MagentaFlame/HackLifeLastWeek/README.md

Helloooo this is last week of design for hack life, and I'm doing a split keyboard!
Ever since I learned about being able to do one from Hack club, I've been looking for opportunities to. Now that I got one, hopefully I have enough free time to do it. I feel bad about not doing my college apps and my tons of hw...

Schematic!

The labels are kind of scuffed. I pretty much made a matrix of 25 keys, using as much as possible, and customized where the pins pointed to so it was easier to route on the pcb. 

PCB!

This took so so long. So currently, most of the letter keys are assembled in a staggered format, similar to a regular keyboard. This is to retain muscle memory for typing and gaming. The ctrl button the left side and space button on the right are still within the 5x5 matrix for the pins, but are one row down for muscle memory.

Code!

I had to create a custom keyboard module using zmk. I learned and implemented making new shields for each side, setting ids, doing soft-off power management, and doing keymaps. In the keymaps, mod-morphs, macros, hold-taps, and regular kps were used to give more complex, unique functionalities. This way, it isn't one/two outputs for each press, but potentially 3/4 depending on which layer (gaming or default) is toggled and the combination of keys pressed. 
I also made sure to write my configs down for future reference and to make sure I don't forget over the few days I do this project.


CAD!


Okay so I wanted the two sides to be vastly different - one hard and modern, while the other more flowy. But, the flowy side isn't to my liking as much as the geometric side b/c I didn't make it flowy enough lol. Anyways, hopefully the color combos will be good. I add only engravings this time, b/c extra details like changing wall geometry and embossing will take time I don't have unfortunately.
The pictures show the colors for the cases. The keycaps for the purple side will be gray and more jagged than the red keycaps on the orange side.
https://cad.onshape.com/documents/0349a2efe14c8a7447e63041/w/2e8c132947c776d3aa7bf3c9/e/34fe7648d6cb8c38b9c40c14 

BOM!

| Item | Qty |	Supplier | Cost/item |	Total Cost |	link |
| ---- | --- |  --- | --- | --- | ----- |
|Lipo batteries 2pc	|1|	Aliexpress|	$6.39|	$6.39|	https://www.aliexpress.us/item/3256813194775738.html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 |
|Hot swap sockets|	1|Aliexpress|	$5.43|	$5.43|	https://www.aliexpress.us/item/2251832764937566.html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|
|2M Resistor (100pc)|	1|	Aliexpress|	$1.86	|$1.86	|https://www.aliexpress.us/item/3256806797741926.html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|
|806k Resistor (100pc)	|1|	Aliexpress|	$2.28|	$2.28|	https://www.aliexpress.us/item/3256804997915352.html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|
|1N5819 diode (100pc)|	1|	Aliexpress|	$2.52|	$2.52|	https://aliexpress.us/item/3256811563559109.html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|
|Outemu Silent Lemon v3 Switch (50pc)|	1|	Aliexpress|	$9.49|	$9.49|	https://www.aliexpress.us/item/3256806837508228.html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|
|XIAO nRF52840|	2|	Seeed Studio|	$9.99|	$19.98	|https://www.seeedstudio.com/Seeed-XIAO-BLE-nRF52840-p-5201.html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|
|Custom pcb|	1|	JLCPCB|	$16.95|	$16.95|	https://cart.jlcpcb.com/shopcart/cart/|
|M2 screws 6mm (200pc)|	1|	Aliexpress|	$2.43|	$2.43|	https://aliexpress.us/item/3256808326585307.html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|
|Estimated total shipping|	1|			$11.10|

Only after making the hardware did I realized just how much it costs, even with Aliexpress and the 11.11 deals (hopefully I can get this approved by then). The microcontrollers and custom pcb cost the most, but that is to be expected. Just once added together, it accumulated to a lot. I think I can get enough hours for the tier 3 funding though.
