MagentaFlame/HackLifeLastWeek/BOM.csv

Item | Qty | Supplier | Cost/item | Total Cost | link
Lipo batteries 2pc | 1 | Aliexpress | $6.39 | $6.39 | https://www.aliexpress.us/item/3256813194775738.html?mp=1
Hot swap sockets | 1 | Aliexpress | $5.43 | $5.43 | https://www.aliexpress.us/item/2251832764937566.html?mp=1
2M Resistor (100pc) | 1 | Aliexpress | $1.86 | $1.86 | https://www.aliexpress.us/item/3256806797741926.html?mp=1&_randl_shipto=US
806k Resistor (100pc) | 1 | Aliexpress | $2.28 | $2.28 | https://www.aliexpress.us/item/3256804997915352.html?mp=1
1N5819 diode (100pc) | 1 | Aliexpress | $2.52 | $2.52 | https://aliexpress.us/item/3256811563559109.html?mp=1&_randl_shipto=US
Outemu Silent Lemon v3 Switch (50pc) | 1 | Aliexpress | $9.49 | $9.49 | https://www.aliexpress.us/item/3256806837508228.html?mp=1
XIAO nRF52840 | 2 | Seeed Studio | $9.99 | $19.98 | https://www.seeedstudio.com/Seeed-XIAO-BLE-nRF52840-p-5201.html
Custom pcb | 1 | JLCPCB | $16.95 | $16.95 | https://cart.jlcpcb.com/shopcart/cart/
M2 screws 6mm (200pc) | 1 | Aliexpress | $2.43 | $2.43 | https://aliexpress.us/item/3256808326585307.html?mp=1&_randl_shipto=US
Custom case + keycaps | 1 | Printing Legion | $15.50 | $15.50 | https://hackclub.slack.com/archives/C083P4FJM46/p1794163829539309
Estimated total shipping | 1 |  |  | $20.10
