MagentaFlame/HackLifeLastWeek/CAD/leftcase - left top plate.step

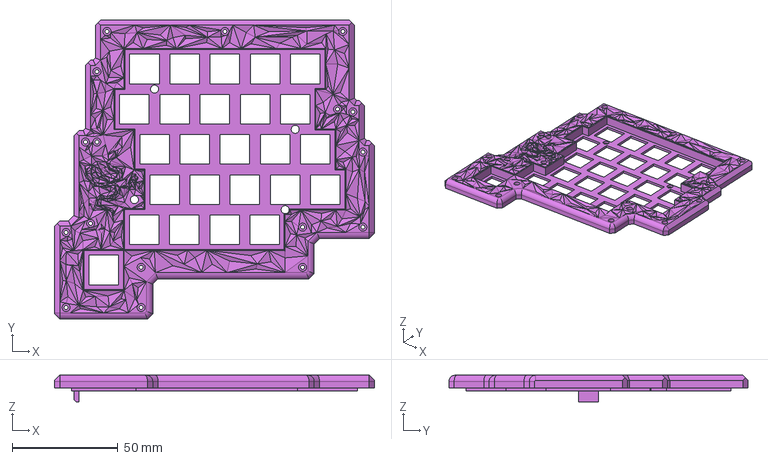
[picture p1: CAD file, 2026-11-08]
CAD/leftcase - left top plate.step
151.7 x 141.8 x 12.6 mm
