MagentaFlame/HackLifeLastWeek/CAD/rightcase - right top.step

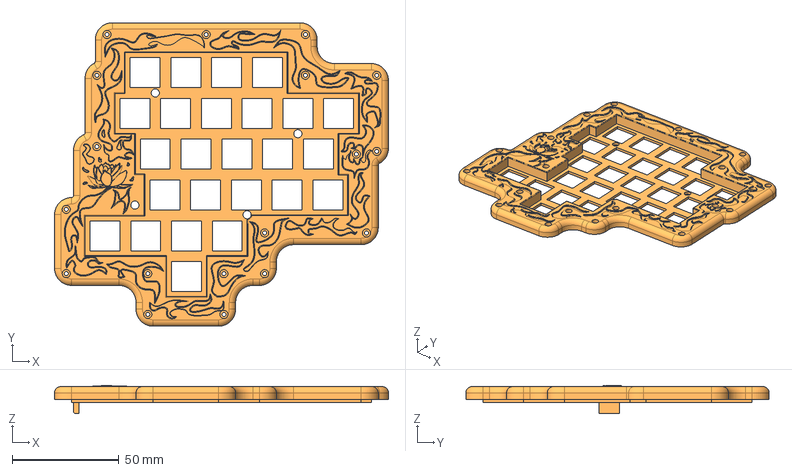
[picture p2: CAD file, 2026-11-08]
CAD/rightcase - right top.step
156.1 x 141.8 x 13.1 mm
