MagentaFlame/HackLifeLastWeek/CAD/rightcase - right bottom.step

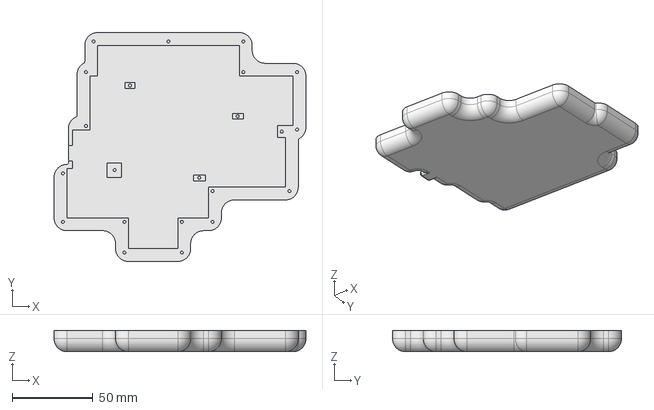
[picture p3: CAD file, 2026-11-08]
CAD/rightcase - right bottom.step
156.1 x 141.8 x 13.2 mm
