MagentaFlame/HackLifeLastWeek/CAD/leftcase - left bottom.step

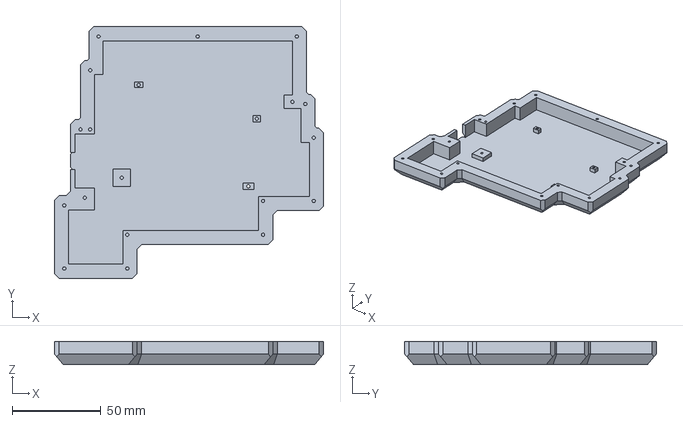
[picture p4: CAD file, 2026-11-08]
CAD/leftcase - left bottom.step
151.7 x 141.8 x 13.2 mm
