MagentaFlame/HackLifeLastWeek/CAD/keyboard hard.step

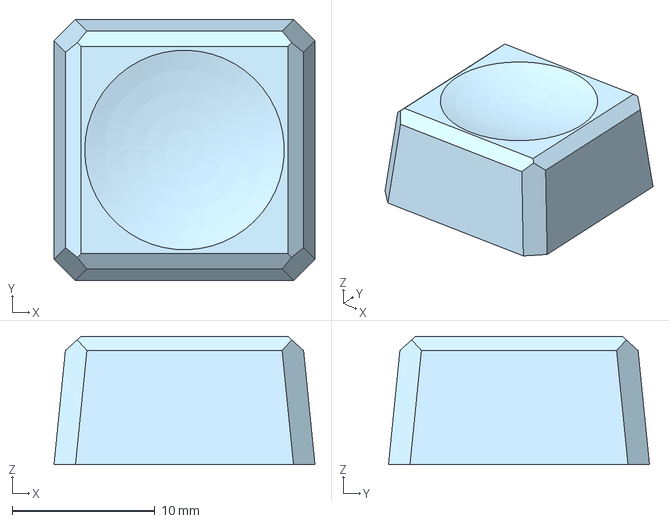
[picture p5: CAD file, 2026-11-08]
CAD/keyboard hard.step
18.3 x 18.3 x 9.00 mm
