MagentaFlame/HackLifeLastWeek/(list of files, cad)

Other CAD files:
CAD/keyboard soft.step
