MagentaFlame/HackLifeLastWeek/PCB design/side.kicad_sch

## KiCad design PCB design/side.kicad_sch (2026-11-06)

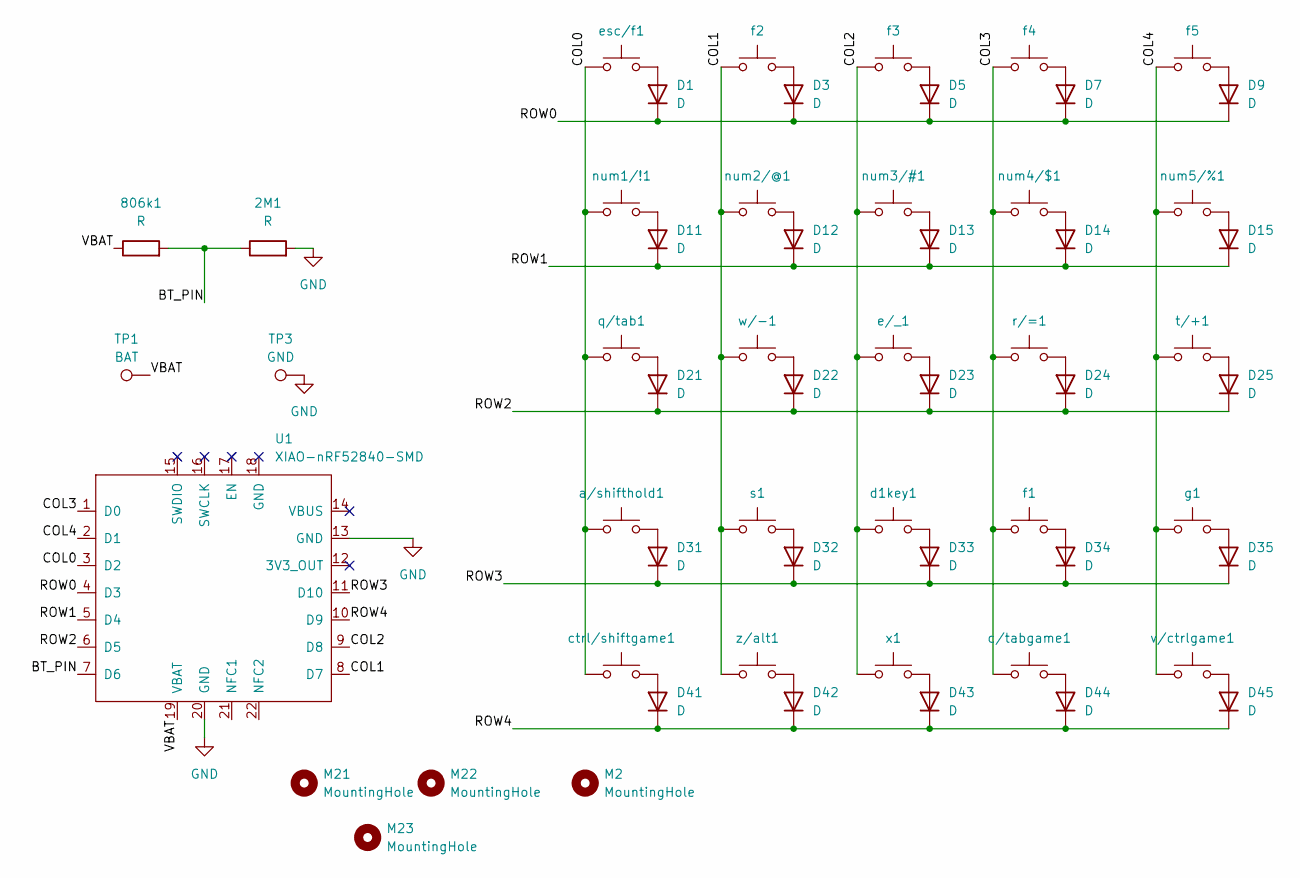
[picture p6: schematic side.kicad_sch]

Parts:
2M1, 806k1: R; R_0805_2012Metric
D1, D3, D5, D7, D9, D11, D12, D13, D14, D15, D21, D22, D23, D24, D25, D31, D32, D33, D34, D35, D41, D42, D43, D44, D45: D; D_SOD-123
M2, M21, M22, M23: MountingHole; MountingHole_2.2mm_M2
TP1: BAT; TestPoint_Pad_D2.0mm
TP3: GND; TestPoint_Pad_D2.0mm
U1: XIAO-nRF52840-SMD; modified-XIAO-nRF52840-SMD
a/shifthold1: SW_Push; SW_MX_HS_CPG151101S11_1u
c/tabgame1: SW_Push; SW_MX_HS_CPG151101S11_1u
ctrl/shiftgame1: SW_Push; SW_MX_HS_CPG151101S11_1u
d1key1: SW_Push; SW_MX_HS_CPG151101S11_1u
e/_1: SW_Push; SW_MX_HS_CPG151101S11_1u
esc/f1: SW_Push; SW_MX_HS_CPG151101S11_1u
f1, f2, f3, f4, f5: SW_Push; SW_MX_HS_CPG151101S11_1u
g1: SW_Push; SW_MX_HS_CPG151101S11_1u
num1/!1, num2/@1, num3/#1, num4/$1, num5/%1: SW_Push; SW_MX_HS_CPG151101S11_1u
q/tab1: SW_Push; SW_MX_HS_CPG151101S11_1u
r/=1: SW_Push; SW_MX_HS_CPG151101S11_1u
s1: SW_Push; SW_MX_HS_CPG151101S11_1u
t/+1: SW_Push; SW_MX_HS_CPG151101S11_1u
v/ctrlgame1: SW_Push; SW_MX_HS_CPG151101S11_1u
w/-1: SW_Push; SW_MX_HS_CPG151101S11_1u
x1: SW_Push; SW_MX_HS_CPG151101S11_1u
z/alt1: SW_Push; SW_MX_HS_CPG151101S11_1u

Connections:
BT_PIN: 2M1.1, 806k1.2, U1.7 (D6)
COL0: U1.3 (D2), a/shifthold1.1, ctrl/shiftgame1.1, esc/f1.1, num1/!1.1, q/tab1.1
COL1: U1.8 (D7), f2.1, num2/@1.1, s1.1, w/-1.1, z/alt1.1
COL2: U1.9 (D8), d1key1.1, e/_1.1, f3.1, num3/#1.1, x1.1
COL3: U1.1 (D0), c/tabgame1.1, f1.1, f4.1, num4/$1.1, r/=1.1
COL4: U1.2 (D1), f5.1, g1.1, num5/%1.1, t/+1.1, v/ctrlgame1.1
GND: 2M1.2, TP3.1, U1.13 (GND), U1.20 (GND)
unnamed: D1.2 (A), esc/f1.2
unnamed: D3.2 (A), f2.2
unnamed: D5.2 (A), f3.2
unnamed: D7.2 (A), f4.2
unnamed: D9.2 (A), f5.2
unnamed: D11.2 (A), num1/!1.2
unnamed: D12.2 (A), num2/@1.2
unnamed: D13.2 (A), num3/#1.2
unnamed: D14.2 (A), num4/$1.2
unnamed: D15.2 (A), num5/%1.2
unnamed: D21.2 (A), q/tab1.2
unnamed: D22.2 (A), w/-1.2
unnamed: D23.2 (A), e/_1.2
unnamed: D24.2 (A), r/=1.2
unnamed: D25.2 (A), t/+1.2
unnamed: D31.2 (A), a/shifthold1.2
unnamed: D32.2 (A), s1.2
unnamed: D33.2 (A), d1key1.2
unnamed: D34.2 (A), f1.2
unnamed: D35.2 (A), g1.2
unnamed: D41.2 (A), ctrl/shiftgame1.2
unnamed: D42.2 (A), z/alt1.2
unnamed: D43.2 (A), x1.2
unnamed: D44.2 (A), c/tabgame1.2
unnamed: D45.2 (A), v/ctrlgame1.2
ROW0: D1.1 (K), D3.1 (K), D5.1 (K), D7.1 (K), D9.1 (K), U1.4 (D3)
ROW1: D11.1 (K), D12.1 (K), D13.1 (K), D14.1 (K), D15.1 (K), U1.5 (D4)
ROW2: D21.1 (K), D22.1 (K), D23.1 (K), D24.1 (K), D25.1 (K), U1.6 (D5)
ROW3: D31.1 (K), D32.1 (K), D33.1 (K), D34.1 (K), D35.1 (K), U1.11 (D10)
ROW4: D41.1 (K), D42.1 (K), D43.1 (K), D44.1 (K), D45.1 (K), U1.10 (D9)
VBAT: 806k1.1, TP1.1, U1.19 (VBAT)
