MagentaFlame/HackLifeLastWeek/PCB design/splitkeyboard.kicad_sch

## KiCad design PCB design/splitkeyboard.kicad_sch (2026-11-06)

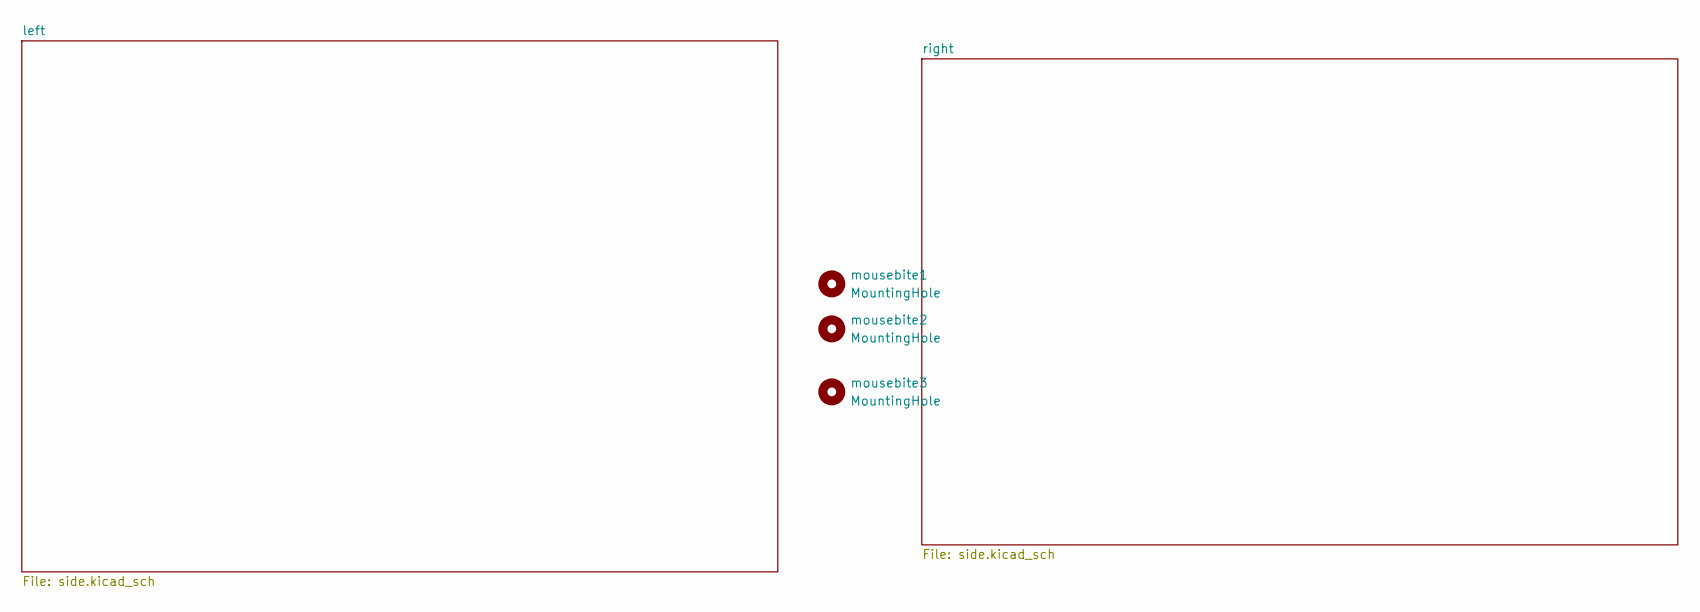
[picture p7: schematic splitkeyboard.kicad_sch]

Parts:
mousebite1, mousebite2, mousebite3: MountingHole; mouse-bite-5mm-slot
