MagentaFlame/HackLifeLastWeek/(commit log)

2026-11-06 Sync FINALLY DA SPLIT KEYBOARD from Half Life
    [BOM.csv]
2026-11-08 Rename gerber_drill.zip to PCB design/gerber_drill.zip
2026-11-08 Rename side.kicad_sch to PCB design/side.kicad_sch
    [side.kicad_sch]
2026-11-08 Rename splitkeyboard.kicad_pcb to PCB design/splitkeyboard.kicad_pcb
    [splitkeyboard.kicad_pcb]
2026-11-08 Rename splitkeyboard.kicad_sch to PCB design/splitkeyboard.kicad_sch
    [splitkeyboard.kicad_sch]
